ruarchi/BeamSplitter/stl/alternatives/frame_for_0.6_nozzle.stl

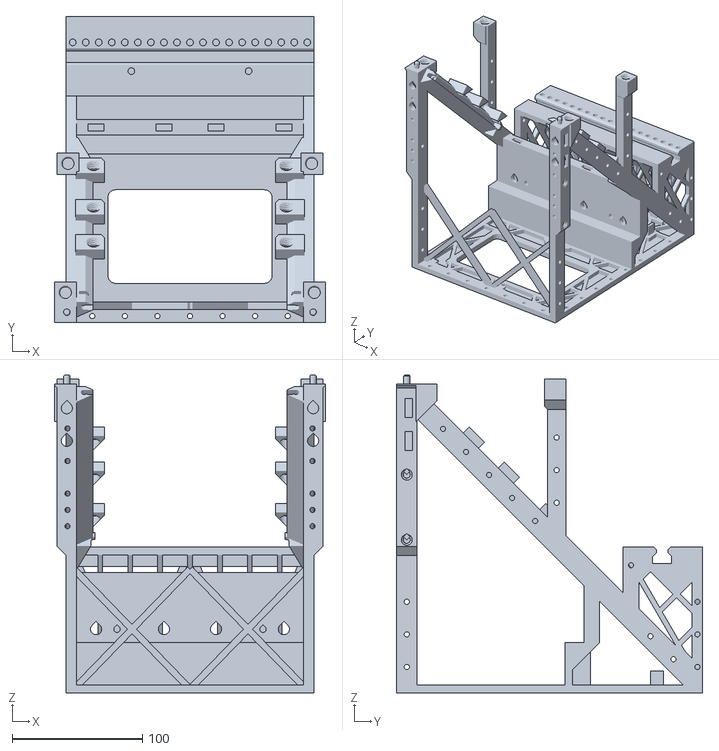
[picture p6: CAD file, 2026-10-24]
stl/alternatives/frame_for_0.6_nozzle.stl
208.0 x 235.0 x 244.0
