ruarchi/BeamSplitter/stl/tests/rail_test.stl

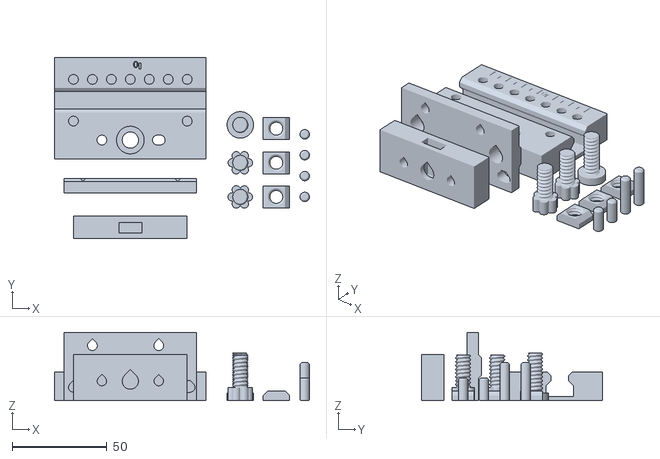
[picture p7: CAD file, 2026-10-24]
stl/tests/rail_test.stl
134.5 x 95.6 x 36.0
