ruarchi/BeamSplitter/stl/tests/thread_test.stl

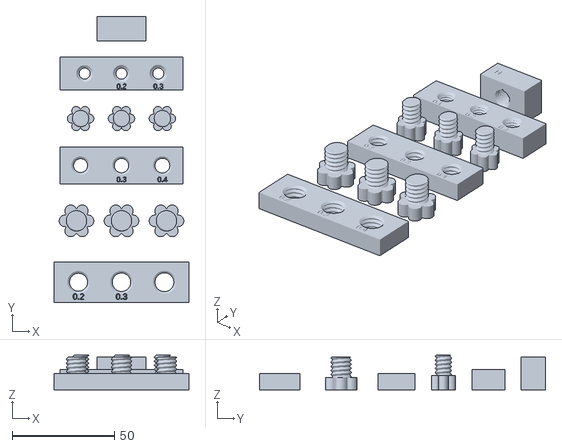
[picture p8: CAD file, 2026-10-24]
stl/tests/thread_test.stl
66.0 x 140.0 x 17.0
