ruarchi/BeamSplitter/stl/05_bottom_carriage.stl

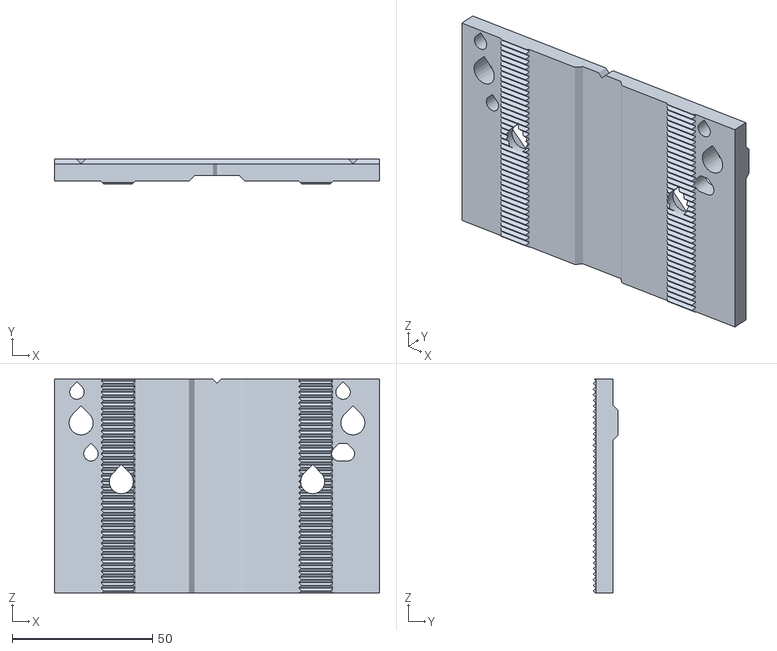
[picture p9: CAD file, 2026-10-24]
stl/05_bottom_carriage.stl
116.0 x 8.80 x 76.2
