ruarchi/BeamSplitter/stl/alternatives/arca_plate.stl

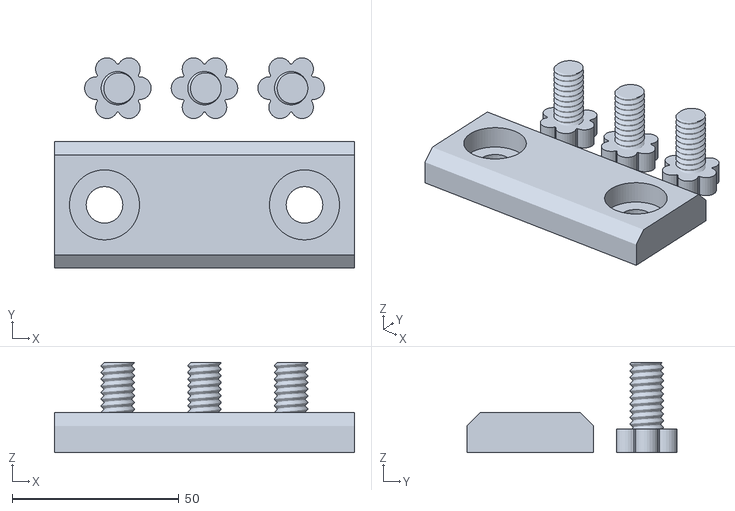
[picture p10: CAD file, 2026-10-24]
stl/alternatives/arca_plate.stl
90.0 x 63.1 x 27.0
