ruarchi/BeamSplitter/stl/tests/groove_test.stl

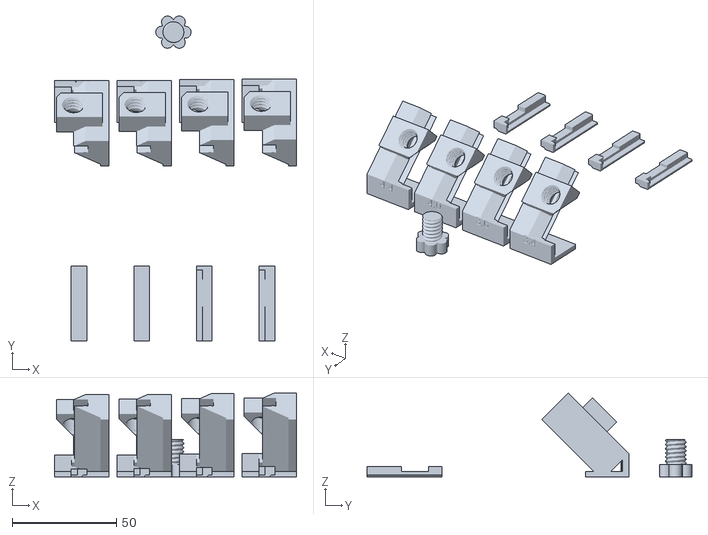
[picture p11: CAD file, 2026-10-24]
stl/tests/groove_test.stl
116.2 x 155.7 x 40.2
