ruarchi/BeamSplitter/stl/14_pins_solid.stl

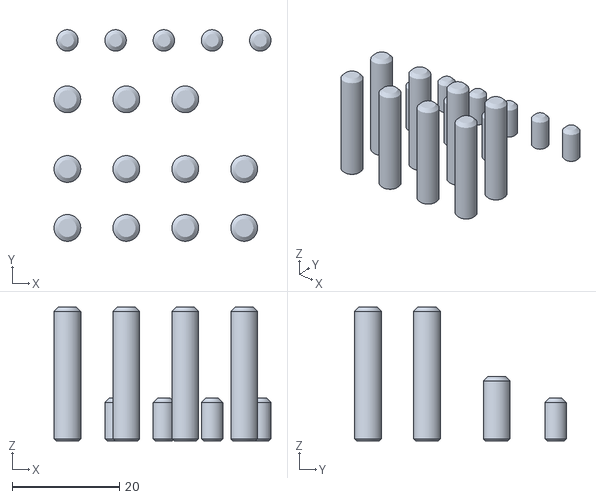
[picture p12: CAD file, 2026-10-24]
stl/14_pins_solid.stl
40.5 x 39.5 x 25.0
