ruarchi/BeamSplitter/stl/tests/pin_test.stl

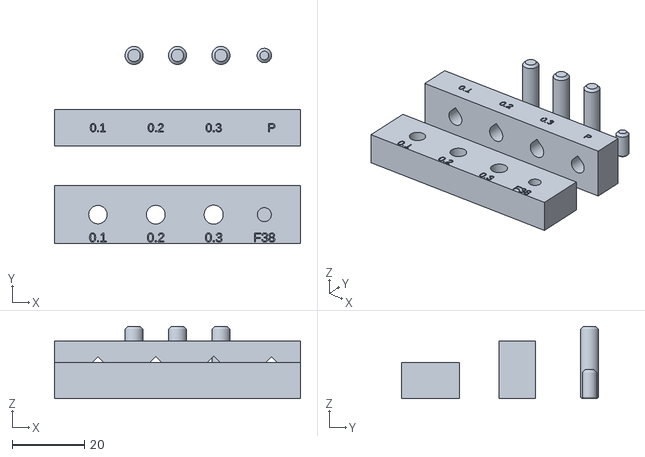
[picture p13: CAD file, 2026-10-24]
stl/tests/pin_test.stl
68.0 x 54.5 x 20.0
