ruarchi/BeamSplitter/stl/08_groove_strips_x2.stl

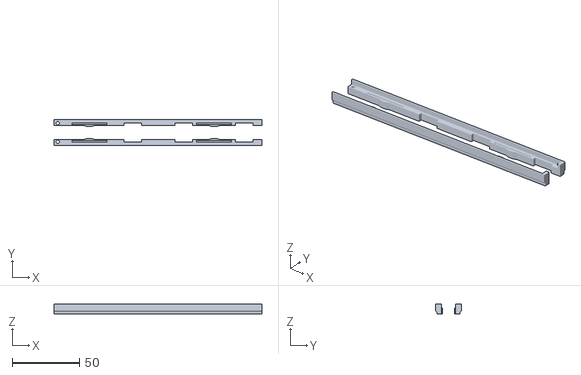
[picture p14: CAD file, 2026-10-24]
stl/08_groove_strips_x2.stl
154.3 x 19.4 x 7.60
