ruarchi/BeamSplitter/stl/15_wrap_clips.stl

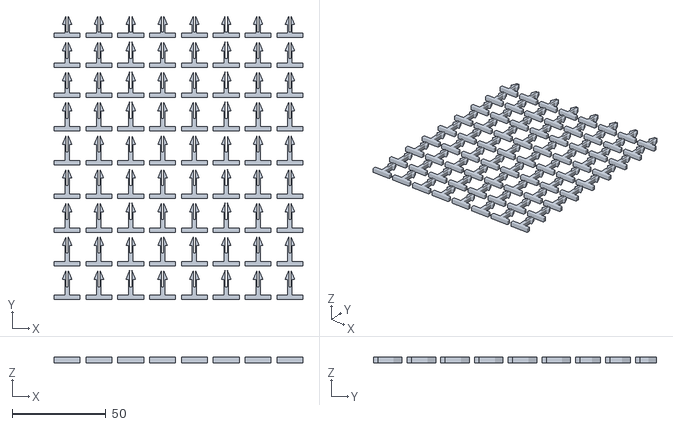
[picture p15: CAD file, 2026-10-24]
stl/15_wrap_clips.stl
133.0 x 151.4 x 3.00
