ruarchi/BeamSplitter/stl/10_swap_shim_3mm_riser.stl

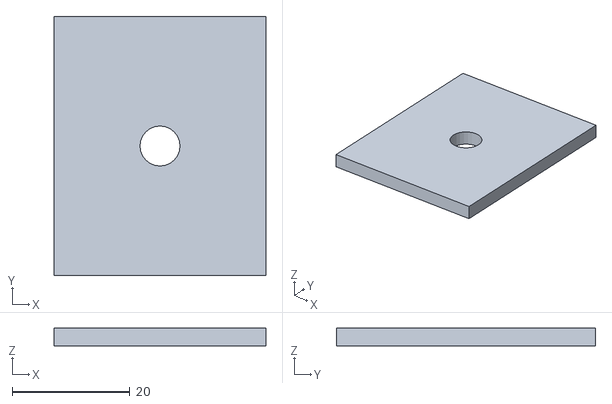
[picture p16: CAD file, 2026-10-24]
stl/10_swap_shim_3mm_riser.stl
36.0 x 44.0 x 3.00
