ruarchi/BeamSplitter/stl/03_wall_rail.stl

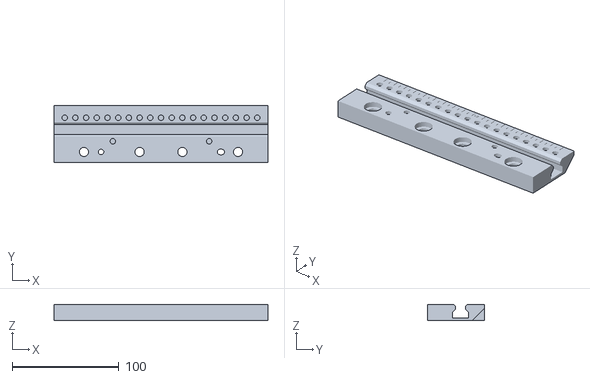
[picture p17: CAD file, 2026-10-24]
stl/03_wall_rail.stl
200.0 x 53.6 x 15.0
