ruarchi/BeamSplitter/stl/09_shim_set_print_2x.stl

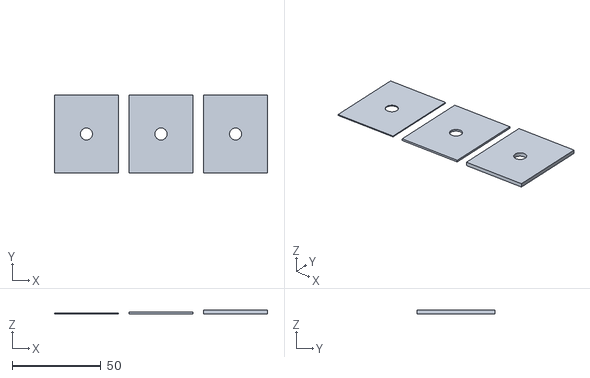
[picture p18: CAD file, 2026-10-24]
stl/09_shim_set_print_2x.stl
120.0 x 44.0 x 2.00
