ruarchi/BeamSplitter/stl/04_rear_carriage.stl

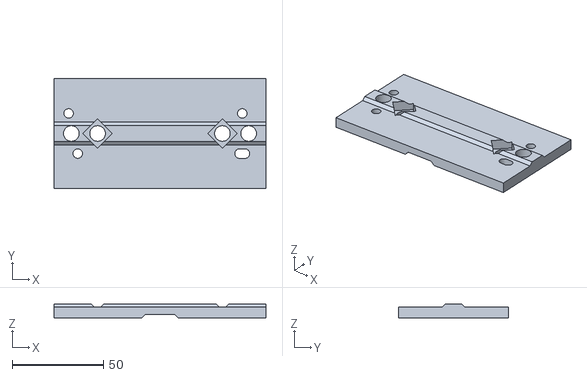
[picture p19: CAD file, 2026-10-24]
stl/04_rear_carriage.stl
116.0 x 60.0 x 7.80
