ruarchi/BeamSplitter/stl/02_top_lid.stl

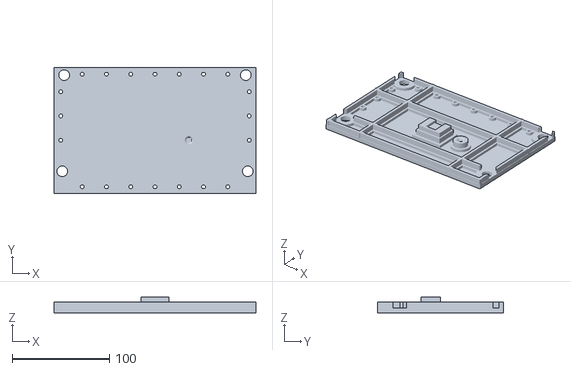
[picture p20: CAD file, 2026-10-24]
stl/02_top_lid.stl
208.0 x 130.0 x 16.2
