ruarchi/BeamSplitter/stl/07_glass_stops_x2.stl

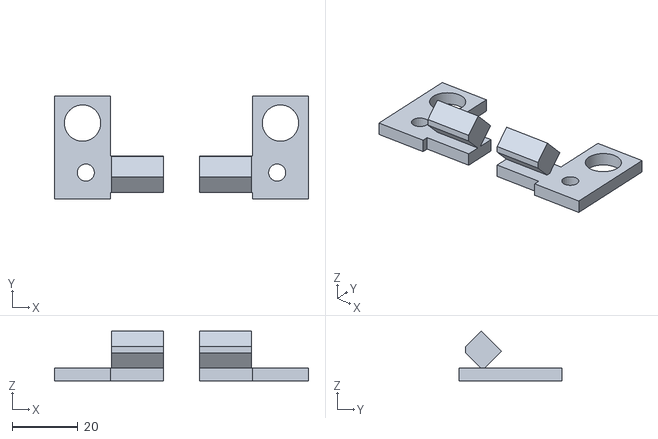
[picture p21: CAD file, 2026-10-24]
stl/07_glass_stops_x2.stl
77.0 x 31.2 x 15.1
