ruarchi/BeamSplitter/stl/06_f38_slides_x2.stl

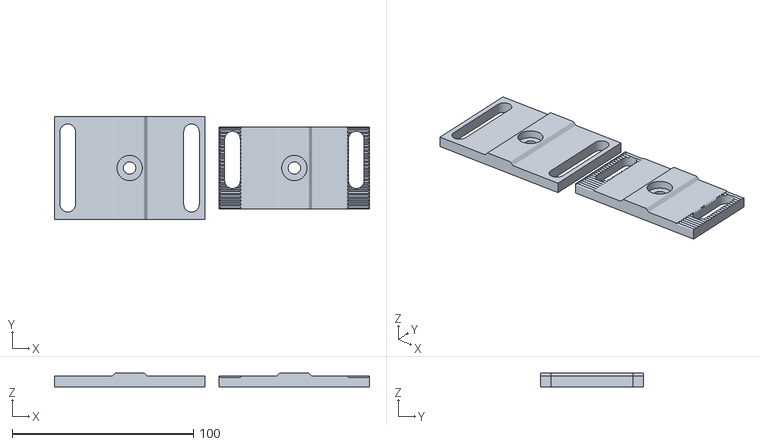
[picture p22: CAD file, 2026-10-24]
stl/06_f38_slides_x2.stl
173.8 x 56.6 x 7.80
