ruarchi/BeamSplitter/stl/12_hardware_nuts_solid.stl

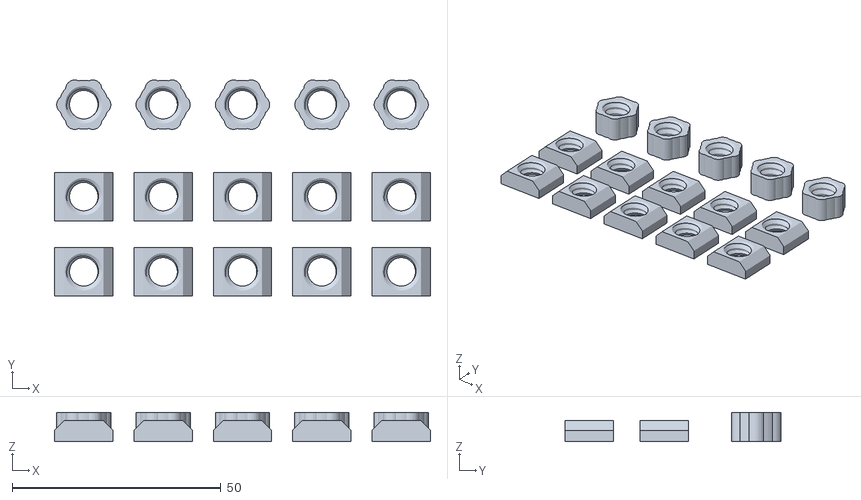
[picture p23: CAD file, 2026-10-24]
stl/12_hardware_nuts_solid.stl
90.0 x 51.7 x 7.00
