ruarchi/BeamSplitter/model/beamsplitter_rig.scad

// BeamSplitter -- dual-camera beam-splitter rig (parametric, 3D-printable).
// A 150 x 150 x 2 mm 50/50 plate beam splitter at 45 deg between two cameras: the rear camera looks
// through the glass, the bottom camera looks up at the reflection. Both slide sideways for stereo.
// Parameters, measuring your gear: docs/CUSTOMIZE.md. Printing, assembly, design: see docs/.
//
// Usage: part = "assembly" draws the whole rig (F5). Any other part name draws one printable part
// in print orientation: F6, then File > Export > STL. Command line:
//   openscad -D 'part="frame"' -o frame.stl beamsplitter_rig.scad
// The console prints a summary of optical margins and clearances; an assert stops the run when a
// parameter combination does not fit. Everything below "DERIVED VALUES" is computed.
//
// Units: mm and degrees.
// World frame: X left/right, Y front/back (the scene is at -Y), Z up. X = 0 is the centreline,
//   Y = 0 the splitter centre, Z = 0 the underside of the base. Splitter centre S = (0, 0, Zs).
//   The coated face has normal (0,-1,-1)/sqrt2 (toward the scene and the bottom camera).
//   The rear camera looks -Y, the bottom camera looks +Z.
// Plate-local frame (grooves, ribs): x = world X; v = along the plate, +v = rear/lower edge
//   (world (0,1,-1)/sqrt2); w = plate normal toward the uncoated back (world (0,1,1)/sqrt2).
//   The coated face is w = 0 (through S); the glass occupies w = 0 .. plate_t, v = -75 .. +75.
//   Mapping: translate([0,0,Zs]) rotate([-45,0,0]) (see place_plate()).

/* [What to draw] */
// Part to draw: "assembly" = the whole rig; any other name = one printable part, laid flat for printing
part       = "assembly"; // [assembly, frame, top_lid, wall_rail, glass_stop, preload_screw, rear_carriage, bottom_carriage, f38_slide, hood, shim_set, swap_shim, groove_test, groove_strip, thread_test, rail_test, pin_test, hardware_screws, hardware_nuts, pin_set, wrap_clips, hood_hardware, arca_plate, splitter_mockup, camera_mockups, insert_check, strip_insert_check, world, none]
// With part = "world": one printed part in its assembled position (for mass, centre of gravity and clash checks)
world_piece = "frame";   // [frame, top_lid, wall_rail, groove_strip, glass_stop, preload_screw, rear_carriage, bottom_carriage, f38_slide, swap_shim, hood, hardware, arca_plate]
// Assembly: draw the camera fields of view (orange = rear, purple = bottom; not parts)
show_fov   = true;
// Assembly: draw the top lid (translucent in preview only)
show_lid   = true;
// Assembly: draw the optional front hood
show_hood  = false;
// Assembly: draw the camera, lens and F38 mock-ups
show_cams  = true;
// Assembly: remove the +X half of frame, lid and hood to look inside
cutaway     = false;
// Assembly: slide the glass this far up-front along its grooves (0 = seated; > 0 hides the lid and stops)
glass_insert = 0;
// Smaller printer: cut the rear deck off the frame at Y = split_y (bolted lap joint, steel M4 screws)
frame_split = false;
// With frame_split: which piece to draw ("both" = side by side)
split_piece = "both";    // [front, rear, both]

/* [Hardware and tripod mount] */
// "printed" = printed thumbscrews, nuts, pins and clips; "steel" = M4 bolts, square nuts, steel dowel pins, heat-set inserts
hardware   = "printed";  // [printed, steel]
// Tripod socket: "insert" = 1/4"-20 heat-set insert (recommended: the loaded rig hangs on it), "printed" = printed 1/4"-20 thread, "arca" = printed Arca-Swiss plate on 2 printed M10 thumbscrews
tripod_mount = "insert"; // [insert, printed, arca]

/* [Stereo] */
// Rear camera sideways offset toward +X, mm (stereo; at most rear_stereo)
stereo_rear = 0;         // [-40:5:40]
// Bottom camera sideways offset toward -X, mm (stereo; give a positive number; at most bot_stereo)
stereo_bot  = 0;         // [-45:5:45]
// Print the stereo clipping readout when a stereo offset is set (ray sampling, ~30 s; false = faster preview)
clip_check  = true;
// Rays across x down the target frame, per camera
clip_grid   = [64, 36];

/* [Measure first: cameras, lenses, F38, filter, glass] */
// Measure these on your own hardware before printing the frame (docs/CUSTOMIZE.md explains how).
// Entrance pupil depth behind the front element, rear lens (parallax method)
ep_15       = 25;
// Entrance pupil depth, bottom lens at its working focal length, from the BARE lens front (filter not counted)
ep_1018     = 25;
// Screw-in IR filter on the bottom lens: ring outer diameter
filt_od     = 65;
// How far the filter sticks out beyond the bare lens front (toward the glass)
filt_len    = 6;
// Camera axis heights: enter the UPPER end of your ruler reading.  An error then leaves the camera slightly LOW
// (rear) or slightly too close to the crosswall (bottom), which the shim_set (0.5 / 1 / 2 mm) takes up:
// shims can only space a camera away from its mount, never pull it closer.
// Rear camera (a6400): [axis height above the tripod face, flange -> tripod socket, flange -> rear LCD]
a6400_meas  = [35, 18, 45];
// Bottom camera (a5100): [axis height above the tripod face, flange -> tripod socket, flange -> rear LCD]
a5100_meas  = [32, 15, 33];
// Rear camera body envelope [width (X), height, depth incl. grip]
a6400_size  = [120.0, 66.9, 59.7];
// Bottom camera body envelope [width (X), height, depth incl. grip]
a5100_size  = [109.6, 62.8, 35.7];
// Rear lens (Sony E 15 mm F1.4 G): [diameter, length mount -> front]
lens_15   = [66.6, 69.5];
// Bottom lens (Sony E 10-18 mm F4 at 18 mm): [diameter, length mount -> front]
lens_1018 = [70.0, 63.5];
// F38 quick release: slide top -> camera tripod face, plate clicked into the base (enter the upper end of the reading)
f38_stack   = 17;
// F38 base footprint [along camera X, along the slide travel]
f38_base    = [54.3, 41.3];
// Locating pins pressed into the slide, into the holes in the F38 base (false = no pins)
f38_pins    = true;
// Locating hole / pin diameter (slide hole = f38_pin_d - 0.1, press fit)
f38_pin_d   = 4.0;
// Pin spacing along camera X, centred on the 1/4" screw
f38_pin_sp  = 30;
// Pin hole depth in the slide (pins stand about 3 mm proud; at most t_slide - 1)
f38_pin_depth = 5;
// Usable depth of the F38 base's 1/4"-20 thread (through hole: depth to the quick-release cavity floor)
f38_thread_depth = 8;
// Length of the 1/4"-20 screw that holds the F38 base (3/8" = 9.5); its engagement is checked
qtr_screw_len = 9.5;
// Release lever / safety knob: [how far it sticks out beyond the base along camera X (0 = inside), its lowest point above the base underside]
f38_lever   = [0, 99];
// Camera-side footprint of the F38 plate (the shims go between camera and F38 plate)
shim_fp     = [36, 44];
// Your glass, measured: [width across X, length along the slope]; the groove strips are made for it
strip_glass = [150, 150];

/* [Optics] */
// Splitter centre height above the base underside
Zs          = 176;
// Target common-frame focal length (19 = the smallest 0.5 mm step that passes with the default IR filter); set fov_f_rear / fov_f_bot the same
target_f    = 19;
// Target frame aspect: "16:9" or "3:2"
target_aspect = "16:9";
// Design distance plate centre -> lens front element
g           = 41.5;
// Required clearance of a lens rim from the other camera's field of view
rim_margin  = 3;
// Lens-to-glass clearance, measured normal to the plate
plate_clear_min = 3;
// Focal length of the drawn rear field of view
fov_f_rear  = 19;
// Focal length of the drawn bottom field of view
fov_f_bot   = 19;
// Aspect of the drawn fields of view: "16:9" or "3:2"
fov_aspect  = "16:9";
// How far the rear field of view is drawn from its pupil
fov_len     = 190;
// Frame / hood clearance outside the target field of view
aperture_margin = 3;
// Minimum clearance of groove lips, stops, bosses and screw heads outside both fields of view
lip_margin_min = 0.5;
// Sensor width (APS-C)
sensor_w    = 23.5;
// Sensor height, 3:2
sensor_h32  = 15.6;
// Frame height, 16:9
sensor_h169 = 13.22;
// Lens clearance envelope: diameter + this
lens_clear_d = 6;
// Lens clearance envelope: length + this
lens_clear_l = 10;
// Beam-splitter plate size (square)
plate_size  = 150;
// Beam-splitter plate thickness
plate_t     = 2.0;
// Glass edge engagement in the groove (clear aperture = plate_size - 2 * glass_engage)
glass_engage = 2;

/* [Glass groove and preload] */
// Groove stack (plate normal, from the coated face down): 0.5 mm hard felt on the LOWER flank (the angle reference;
// the glass rests on it by gravity), the 2 mm glass, then one 0.5 mm felt layer on the UPPER flank (add a second only
// if the glass rattles), pressed by the printed preload thumbscrews.  Cut the upper felt
// strip no wider than the groove roof (x_ul .. x_gb, printed in the summary): a wider strip hangs into the view.
// Groove width: deliberately generous so the glass always fits; the slack is taken up by the felt and the thumbscrews
groove_w    = 4.0;
// Lower-flank felt thickness (the lower flank face sits felt_t below the coated face)
felt_t      = 0.5;
// Gap glass edge -> groove bottom
edge_float  = 1.0;
// Lip rule: the lower flank face stands at most 1.5 mm proud of the coated face ...
lip_proud   = 1.5;
// ... for this width, then it bevels away
lip_flat    = 1.5;
// Bevel run in X per mm of depth (>= 1.46 = the grazing-ray slope; both flanks)
bevel_k     = 1.6;
// Upper flank starts this far outboard of the lower lip edge (+ 0.5 per mm of groove_w above 3.2, see x_ul_of())
ul_off      = 1.0;
// Upper flank thickness above the groove roof
back_flank  = 3.5;
// Felt pad on the closed lower-rear end stop
end_pad     = 1.0;
// Clearance glass (+ felt) -> top glass_stop
stop_gap    = 0.5;
// Closed end-stop thickness
end_t       = 5;
// Top-front glass stop, one per side (printed: hooked on the lid pin, clamped by the lid; steel: M4 bolt along the groove)
// Stop block thickness along the groove
stop_len    = 8;
// Stop inner edge |X| (beyond the glass end, outside the views: asserted)
stop_x0     = 71;
// w range of the stop block (covers the glass edge + felt)
stop_w      = [-6, 2.7];
// Steel: M4 x 16 socket head stop bolt
stop_bolt_len = 16;
// Minimum distance of anything to the frame front face y_front
front_margin = 2;
// Preload screws through the UPPER flank, perpendicular to the glass
// "printed" = printed M10 thumbscrews with felt on the tip; "m4" = M4 nylon screw + square nut
preload_type = "printed";// [printed, m4]
// Screw positions along the groove (the rear one sits where the rear lens clears its head at full stereo travel)
preload_v   = [-18, 20, 65];
// Screw axis |X| (the tip straddles the glass edge)
x_pl        = 74;
// Printed thread major diameter
ps_d        = 10;
// Printed thread pitch (45° flanks, support-free; 1.5 .. 2.5 allowed)
ps_pitch    = 2.0;
// Radial clearance of the printed internal threads: print thread_test and pick the best fit (0.2 / 0.3 / 0.4)
ps_clear    = 0.2;
// Boss wall around the thread
ps_wall     = 3;
// preload_screw threaded length (boss 10 + 2 mm adjustment)
ps_len      = 12;
// Thumb head [diameter over the lobes, height]
ps_head     = [17, 6];
// Preload boss height above the groove roof (= thread length)
boss_h      = 10;

/* [Swappable groove strips] */
// The glass sits in two printed groove strips (one per side) that slide into a channel in the frame's diagonal ribs.
// The ANGLE is still set by the frame: each strip's flat underside rests on the rib's seat face (the plane
// w = -lip_proud), so a strip of uniform thickness cannot change the angle.  The strip carries the lower lip (felt
// face = the reference face), a spine that fills the channel up to its roof, and the lower-rear end stop: a glass that
// is a little too wide / narrow / long / short only needs new strips (strip_glass, in "Measure first"), never a new
// frame.  Two leaf springs in the spine press the strip onto the seat, so it stays in by itself; under each thumbscrew
// the spine drops below the glass top, so the screws press only the glass.  The strips stay inside the rib envelope
// (same optical margins).  They print on their outer face (springs = vertical walls, no bridges).
// true = swappable strips; false = groove integral in the frame (always with hardware = "steel")
groove_strips = hardware == "printed";
// Frame channel length clearance at the lower-rear end (frame geometry)
strip_clr   = 0.2;
// Channel outer wall |X| (frame geometry; the rib keeps x_ch .. x_rw of wall for the roof and the bosses)
x_ch        = 81;
// Strip spine height above the coated face under each thumbscrew (the screw tips must reach the glass top first)
strip_floor = 1.0;
// Strip top -> channel roof clearance (the springs take up the rest)
strip_top_clr = 0.5;
// Strip outer face -> channel wall clearance
strip_side_clr = 0.4;
// Lower-rear end cap thickness (glass end stop) at the nominal glass length (frame geometry: sets the channel length)
strip_cap   = 2.0;
// Lateral key: a ridge on the rib seat (|X| range, under the strip's spine; frame geometry) ...
key_x       = [78.8, 80.2];
// ... ridge height above the seat (frame geometry); the strip underside is relieved over it (a step, open outboard)
key_h       = 0.6;
// ... play between the strip's step and the ridge's inner face (the ridge stops the strip moving outboard)
key_clr     = 0.3;
// Hold-down springs: a thin leaf in the spine top with a bump that stands proud of the roof.  Centres along the groove
// (between the thumbscrews) ...
spring_v    = [-50, 42.5];
// ... free length of each leaf
spring_len  = 26;
// ... leaf thickness
spring_t    = 0.8;
// ... free room under the leaf
spring_gap  = 1.0;
// ... how far the bump stands above the roof (= how far the leaf bends when the strip is in)
spring_bump = 0.35;
// Pull hole through the spine near the open end (hook a bent paper clip in it to pull the strip out)
strip_pull_d = 2.5;

/* [Frame] */
// Side-truss member thickness (X): side plane x = inner_hw .. wall_out
wall_t      = 8;
// Inner face of the side plane |X| (glass + groove + rib)
inner_hw    = 87;
// Base plate thickness (bottom chord; the X-braces take the racking)
base_t      = 6;
// Frame front face Y (glass stop + margin: asserted)
y_front     = -65;
// Frame rear face Y
y_back      = 170;
// Lid rear edge Y (splitter zone)
y_zone_end  = 65;
// Rear deck plate thickness (the rail band under it is rail_band_d deep)
deck_t      = 6;
// Rear carriage plate thickness
t_rear_carriage = 6;
// f38_slide thickness, both slides
t_slide     = 6;
// Front column outboard width (X) at the front face
col_w       = 15;
// Front post depth (Y)
col_d       = 16;
// Clearance highest glass / stop / rib point -> lid underside
lid_clear   = 3;
// Lid rib thickness
rib_t       = 3;
// Rear-deck rib thickness
deck_rib_t  = 3.5;
// Structural deck ribs at x = 0, +-rib_pitch_x (the rear W-truss nodes) ...
rib_pitch_x = 46;
// ... plus intermediate deck ribs at these |x| (keeps the deck / rail-band bridges <= 20 mm)
deck_rib2_x = [23, 69];
// Rear post Y span (carries the rear lid screws)
rp_y        = [51, 65];
// Rear post inner face |X|
rp_x0       = 85;
// Deck strut (rib -> deck front edge) depth in Y
strut_d     = 12;
// Deck side-rib web thickness (outer part of the side plane)
side_rib_t  = 5;
// Diagonal rib cross-section (w) below the groove zone (its underside continues the groove-zone band: no mid-air start)
diag_w_lo   = [-7, 7];
// Tapered gusset at the rib's lower-rear end (where the thick groove rib meets the side-plane band and the rear post):
// longest length (shortened automatically to stay 3 mm above the crosswall top)
gusset_max  = 21;
// Lightening: floor of the blind base pockets (4 layers at 0.4)
skin_t      = 1.6;
// Lattice web thickness (base)
web_t       = 3.5;
// Through-truss members (deck ribs)
truss_web   = 4;
// Diamond lattice pitch, deck ribs (through)
truss_pitch = 40;
// Triangle lattice edge, base pockets (open-top, blind)
base_tri    = 56;
// Recess in the base under the bottom camera's LCD
lcd_recess  = true;
// Window: the recess goes right through the base, so you can see the bottom camera's screen and reach its buttons
lcd_window  = true;
// Window corner radius
lcd_window_r = 6;
// LCD recess floor thickness
lcd_floor_t = 2.0;
// Minimum clearance bottom camera LCD -> base / recess floor at the lowest slide position
lcd_clear_min = 3;
// Side accessory points (1/4"-20 sockets in the front column outer faces): heights
acc_z       = [117.5, 167.5];
// Hood mounting screw heights
hood_bolt_z = [Zs + 17.5, Zs + 42.5];
// Rear rail band depth below the deck top (T-slot 12.7 printed / 9.8 steel)
rail_band_d = hardware == "printed" ? 15 : 13;
// CROSSWALL: vertical wall between the side trusses behind the bottom camera.  The bottom carriage rides on the front
// face y_wf of the WALL_RAIL (a separate bar with the T-slot, printed lying flat), which is bolted to the flat
// mounting face of the wall at y_wf + wrl_t.
// Wall band thickness (Y) behind the wall_rail (bolts, nut slots, pin holes)
cw_band_t   = hardware == "printed" ? 12 : 9;
// Base kept solid under the wall foot: y_wf - web_t .. y_wf + cw_foot_t + web_t
cw_foot_t   = 12;
// Wall thickness below the rail (its front face sits wrl_relief behind the rail face) ...
cw_web_t    = 6;
// ... with blind triangular pockets from the back, leaving this front skin
cw_skin     = 1.6;
// Pocket webs (45° members) in the wall
cw_web      = 4;
// Pocket lattice pitch (45° diamonds; the bottom row is cut into triangles)
cw_pitch    = 24;
// Two vertical stiffening ribs on the wall's back face at x = +-cw_rib_x ...
cw_rib_x    = 30;
// ... [width X, depth Y beyond the web], from the base to the 45° knee under the band
cw_rib      = hardware == "printed" ? [6, 14] : [6, 10];
// Wall rail (T-slot) centre height (the clamp screws sit in the front X-brace window: asserted)
wr_z        = 70;
// Pin rows at wr_z +- wr_off (index row up, datum pair down)
wr_off      = hardware == "printed" ? 11 : 9;
// Scale strip on the rail face above the carriage top (engraved ticks)
wr_scale_h  = 5;
// Index holes over this length (x = -90 .. 90, 10 mm pitch)
wr_idx_len  = 180;
// WALL_RAIL: printed lying flat (back face on the bed), so its T-slot opens upward: no overhangs, no mid-air starts.
// Rail thickness (Y): T-slot (12.7 printed / 9.8 steel deep) + floor
wrl_t       = hardware == "printed" ? 15 : 12;
// Rail bottom edge relative to wr_z (through-bolt row + its counterbore + wall)
wrl_lo      = hardware == "printed" ? -31 : -18;
// The wall web face sits this far behind the rail face: the carriage bears on the rail only
wrl_relief  = 0.5;
// Rail bottom edge above the wall's rail seat (the pins locate the rail, not the seat)
wrl_gap     = 0.3;
// Through-bolt + alignment-pin row relative to wr_z (below the datum row)
wrl_bolt_h  = hardware == "printed" ? -21 : -11;
// Through-bolts: head in a counterbore in the rail face (under the carriage), nut dropped into a slot from the band top
wrl_bolt_x  = [-72, -20, 20, 72];
// Through-bolt length (printed M8 x 21 + printed T-nut / steel M4 x 16 + square nut)
wrl_bolt_len = hardware == "printed" ? 21 : 16;
// Wall material between the mounting face and the nut slot
wrl_nut_f   = 3;
// 2 alignment pins: round rail hole at [0], slotted (along X) at [1]; wall holes round (teardrop)
wrl_dowel_x = hardware == "printed" ? [-56, 56] : [-50, 50];
// Alignment pin length (printed 5 mm pins pressed in; steel: 4 mm dowels, reamed, glued)
wrl_dowel_len = 12;
// Alignment pin hole depth in the wall
wrl_dowel_wall = 6.5;
// X-braces between the two side trusses (racking in the X-Z plane): member width (in the brace plane)
brace_w     = 5;
// X-brace member thickness (Y)
brace_t     = 6;
// Steel: 2 x 4 mm lid dowels in the front post tops (the lid does not rely on screw friction): length
lid_dowel_len   = 12;
// Steel: lid dowel glued into the post top this deep (3 mm proud)
lid_dowel_depth = 9;
// Steel: blind dowel hole depth in the lid underside
lid_dowel_lid   = 3.5;

/* [Printed hardware] */
// Printed threads: two standards with the same 2 mm pitch and 45° flanks: M10 x 2 (ps_d / ps_pitch / ps_clear) where
// space allows (lid, Arca plate), M8 x 2 where a 13 mm head must fit (carriage and slide clamps, wall_rail bolts, hood).
// Screws and bolts print standing (head on the bed), nuts print flat (thread axis vertical), 100 % infill.
// Second printed standard: M8 x 2 (pitch ps_pitch, clearance ps_clear, same 45° form)
t8_d        = 8;
// Lid thumbscrew M10: thread length under the head
lid_sl      = 20;
// Lid thumbscrew lobed head [diameter over the lobes, height]
lid_sh      = [20, 7];
// Carriage rail clamp thumbscrew M8: thread length under the head (tip past the T-nut: asserted)
cs_len      = 17;
// Clamp thumbscrew lobed head [diameter, height], with a hex socket (long key through the front brace window)
cs_head     = [13, 7];
// Hex socket across flats in the clamp thumbscrews and wall_rail bolts
hex_key     = 5;
// T-nut M8 [across the slot, along the slot, thickness]; its 45° top bevels bear on the slot roof
tnut        = [14, 11.6, 5];
// Slide clamp T-bolt M8: square head [side, thickness], sits in a diamond pocket under the carriage
sb_head     = [11, 3.5];
// Slide clamp T-bolt thread length above the head (carriage + slide + thumb-nut)
sb_len      = 16;
// Slide thumb-nut M8 [diameter over the lobes, height]; its bed face is the bearing face
sn_size     = [13, 7];
// wall_rail bolt M8 head [diameter, height] (counterbored under the carriage, hex socket)
wb_head     = [14, 4];
// Printed pins: datum / vernier / wall_rail alignment pin diameter (F38 pins: f38_pin_d)
pin_d       = 5;
// Slip-fit pin hole = pin_d + pin_clr (print pin_test and pick: 0.1 / 0.2 / 0.3)
pin_clr     = 0.2;
// Press-fit pin hole = pin_d + pin_press (alignment pins in the crosswall band)
pin_press   = 0.0;
// glass_stop ear thickness = how far the front post tops sit below frame_top (the ear lies there under the lid)
ear_t       = 4;
// Integral lid pins stand this far above frame_top
lid_pin_up  = 3.0;
// Printed 1/4"-20 UNC female threads for steel screws (printed tripod socket, lid and side accessory points):
// radial clearance at the major diameter (thread_test: 0.1 / 0.2 / 0.3)
unc_clr     = 0.2;
// Printed minor (hole) diameter (UNC 2B: 4.98 .. 5.26; printed holes come out ~0.1 small)
unc_minor   = 5.35;
// tripod_mount = "printed": thread depth (tripod screws engage at most this deep)
tri_thr_depth = 12;
// wrap_clip grip lengths: side members / base + lid / deck ribs
wrap_grip   = [8.5, 6.5, 4.5];
// Number of clips of each length on the wrap_clips plate (incl. spares)
wrap_qty    = [48, 16, 8];

/* [Holes, inserts and steel hardware] */
// 1/4"-20 clearance hole
qtr_clear   = 6.8;
// 1/4"-20 screw head diameter (counterbored into the slide underside)
qtr_head_d  = 13;
// 1/4"-20 screw head height
qtr_head_h  = 4;
// M4 clearance hole
m4_clear    = 4.6;
// Counterbore for an M4 socket head: diameter
m4_head_d   = 8.5;
// Counterbore for an M4 socket head: depth
m4_head_h   = 4.2;
// M4 square nut: width
sqnut_w     = 7.0;
// M4 square nut: thickness
sqnut_t     = 2.5;
// Added to nut width / thickness for nut traps
nut_clear   = 0.3;
// Pin holes (printed pins: slip fit; steel: 3.8, reamed to 4.0)
dowel_hole  = hardware == "printed" ? pin_d + pin_clr : 3.8;
// Steel: lid dowel holes in the post tops (reamed to 4.0, pin glued in with a drop of CA)
lid_dowel_hole = 3.8;
// Carriage datum / vernier pin length (printed 5 x 25 / steel 4 x 25; at least 3 mm proud of the carriage: asserted)
dowel_len   = 25;
// Blind pin / index hole depth in the rails
dowel_depth = 9;
// Heat-set insert 1/4"-20: hole diameter
ins14_d     = 8.0;
// Side accessory points: 1/4"-20 x 10 insert depth
ins14_depth = 10;
// Heat-set insert 3/8"-16: hole diameter
ins38_d     = 11.5;
// Heat-set insert 3/8"-16: hole depth
ins38_depth = 12;
// Lid 1/4"-20 socket depth (leaves 3 mm over the flocked underside)
lid_ins_depth = 8;
// Zip-tie / wrap hole diameter
zip_d       = 4;
// Zip-tie / wrap hole pitch
zip_pitch   = 25;

/* [Tripod] */
// One socket in the base underside, in the crosswall foot just behind the wall front face: stiff plate contact on
// both sides of the screw.
// Socket X
tri_x       = 0;
// The socket pad starts this far behind the crosswall front face
tri_gap     = 2.4;
// 1/4"-20 x 8 mm insert depth (tripod screws engage <= 6.5)
tri_ins_depth = 8;
// Material above the insert (>= 2)
tri_roof    = 2;
// Pad diameter (round boss merged into the base)
tri_pad_d   = 16;
// Base left solid around the socket = tripod plate contact area
tri_solid_d = 46;
// true: 3/8"-16 insert instead of 1/4"-20
tri_38      = false;

/* [Rails, carriages and slides] */
// Rear rail band width (Y)
rail_w      = 36;
// Index hole pitch
rail_pitch  = 10;
// Guide groove width at the rail top (the carriage tongue rides in it); tongues and grooves have 45° sides
key_w       = hardware == "printed" ? 13 : 10;
// Guide groove depth
key_d       = 2;
// T-slot neck width (retains the T-nut)
neck_w      = hardware == "printed" ? 9 : 5;
// T-slot neck depth
neck_d      = 2.5;
// Extra nut-chamber depth below the nut (bolt tip room)
bolt_runout = 1.0;
// Tongue clearance per side
tongue_clear = 0.2;
// Carriage -> rail clamp head seat above the carriage's rail face (printed: the thumbscrew head sits on the carriage)
clamp_seat  = hardware == "printed" ? 6 : 3;
// Rear (deck T-slot) clamp screw length
clamp_bolt_len = hardware == "printed" ? cs_len : 12;
// Bottom (wall_rail T-slot, same profile) clamp screw length
wclamp_bolt_len = hardware == "printed" ? cs_len : 12;
// Rear carriage (clamp screws + pins outside the F38 slide, reachable from above): length X
rc_len      = hardware == "printed" ? 116 : 110;
// Rear carriage width Y
rc_width = 60;
// Rear carriage clamp axis |x|
rc_clamp_x  = hardware == "printed" ? 48.5 : 46;
// Rear carriage datum pin spacing
rc_datum_sep = hardware == "printed" ? 90 : 86;
// Rear carriage vernier pin holes x
rc_vern = [-50, 45];
// Rear rail pin rows at +-rc_idx_off
rc_idx_off = 11;
// Rear rail index holes over this length
rc_idx_len = 180;
// Bottom carriage (flat plate on the wall_rail; clamp screws + pins outside the slide): length X
bc_len      = hardware == "printed" ? 116 : 110;
// Bottom carriage clamp axis |x|
bc_clamp_x  = hardware == "printed" ? 48.5 : 46;
// Bottom carriage datum pin spacing
bc_datum_sep = hardware == "printed" ? 90 : 86;
// Bottom carriage vernier pin holes x
bc_vern = [-50, 45];
// Rear slide travel (fore-aft, Y) for viewpoint matching
rear_travel = 40;
// Bottom slide travel (up-down, Z) for viewpoint matching
bot_travel  = 20;
// Rated rear stereo travel +- (5 mm index steps via the vernier holes; lens clearance asserted)
rear_stereo = 40;
// Rated bottom stereo travel +-
bot_stereo  = 45;
// Slide <-> carriage guide: 45° trapezoid tongue under the slide (root width) in a carriage groove ...
guide_w     = 20;
// ... its depth; wide enough to hide the 1/4" screw head inside it
guide_d     = 2;
// Steel: carriage material between its slide face and the slide clamp nut
slide_nut_roof = 1.5;
// Steel: M4 x 12 slide clamp bolts ...
slide_bolt_len = 12;
// ... under M4 fender washers DIN 9021 (12 mm OD, 0.8 .. 1.2 thick)
slide_washer_t = 1.0;
// Bottom carriage plate thickness
bc_t        = 6;
// Bottom slide slots sit this far above the slide centre (the clamp heads are then in a front X-brace window: asserted)
bot_slot_shift = 4.5;
// Serrations between the bottom slide and its carriage: the camera weight is held by teeth, not clamp friction
// (Z then indexes in serr_pitch steps; false = smooth, friction only)
bot_serr    = true;
// Serration pitch = Z index step (45° teeth)
serr_pitch  = 2;
// Serration tooth height (peak to valley)
serr_depth  = 1;

/* [Lid, hood and shims] */
// Lid plate thickness
lid_t       = 5;
// Lid plate left under the top pockets (light-tight, flocked underneath)
lid_skin    = 2.0;
// Lid rib height
lid_rib_h   = 6;
// ISO 518 cold shoe: slot width
shoe_w      = 18.8;
// Cold shoe slot height
shoe_h      = 2.2;
// Cold shoe throat width
shoe_throat = 12.6;
// Cold shoe length
shoe_len    = 20;
// Cold shoe lip thickness
shoe_lip    = 3.0;
// Cold shoe side walls
shoe_wall   = 5.0;
// Optional hood length
hood_len    = 25;
// Hood wall thickness
hood_wall   = 2.0;
// shim_set thicknesses (camera <-> F38 plate)
shim_t      = [0.5, 1, 2];

/* [Printer] */
// Printer build volume [X, Y, Z]; every large part is checked against it
bed_limit   = [250, 250, 245];

/* [Resolution] */
// Facets: small holes
fn_small = 24;
// Facets: bosses, grips, lens envelopes
fn_big   = 64;
// Printed threads: facets per turn (helical-grid polyhedron, see thread_rod())
fn_thr   = 64;

/* [Hidden] */
// --- DERIVED VALUES (computed; do not edit) ---
// camera vectors: [W (X), H, D (incl. grip), axis height above tripod face, flange->tripod-socket, flange->rear LCD]
cam_a6400 = concat(a6400_size, a6400_meas);
cam_a5100 = concat(a5100_size, a5100_meas);
swap_shim_t = cam_a6400[3] - cam_a5100[3];
s2   = sqrt(2);
eps  = 0.01;

nut_ch_w  = sqnut_w + 2 * nut_clear;
nut_ch_h  = sqnut_t + 0.5 + bolt_runout;
hw_p      = hardware == "printed";
t8_clear  = t8_d + 0.6;
tn_w      = hw_p ? tnut[0] : sqnut_w;
tn_l      = hw_p ? tnut[1] : sqnut_w;
tn_t      = hw_p ? tnut[2] : sqnut_t;
tn_top_w  = hw_p ? neck_w + 0.4 : sqnut_w;
tn_ch_w   = tn_w + 2 * nut_clear;
tn_ch_l   = tn_l + 2 * nut_clear;
cl_d      = hw_p ? t8_clear : m4_clear;
ch_r      = hw_p ? cs_head[0] / 2 : m4_head_d / 2;
sl_slot_w = hw_p ? t8_clear : m4_clear;
sl_edge   = hw_p ? 3.0 : 3.5;
sl_stack  = hw_p ? sn_size[1] : slide_washer_t + m4_head_h;
sl_flange = hw_p ? sn_size[0] : 12;
wrl_clr   = hw_p ? t8_clear : m4_clear;
wrl_hd    = hw_p ? wb_head[0] + 0.6 : m4_head_d;
wrl_hh    = hw_p ? wb_head[1] : m4_head_h;
wrl_half  = hw_p ? 100 : inner_hw + wall_t;
pin_hole  = pin_d + pin_clr;
pin_phole = pin_d + pin_press;
unc_P     = 25.4 / 20;

function tan_h(f)      = sensor_w / 2 / f;
function tan_v(f, asp) = (asp == "3:2" ? sensor_h32 : sensor_h169) / 2 / f;

R15   = lens_15[0] / 2;
R1018 = lens_1018[0] / 2;
L15   = lens_15[1];
L1018 = lens_1018[1];
tv_t  = tan_v(target_f, target_aspect);
th_t  = tan_h(target_f);
wall_out = inner_hw + wall_t;

// Lens rim at y=-R outside the other camera's half-angle theta seen from
// pupil distance D = g + ep:  tan(theta) <= (g - m) / (g + ep + R).
// The rear lens sits on the uncoated side -> the glass thickness is added.
function g_min_for(R, ep, extra) =
    max(R + (plate_clear_min + extra) * s2,
        (rim_margin + tv_t * (ep + R)) / (1 - tv_t));
// The bottom lens wears a screw-in IR filter: a ring of radius Rfilt reaching filt_len beyond the bare front.
// Its front rim sits filt_len closer to the glass (g - filt_len) but ep_1018 is still measured from the bare front,
// so the pupil (and D) do not move with it: the filter rim is a second, narrower "lens rim" nearer the plate.
Rfilt = filt_od / 2;
function g_min_filt(Rf, fl, ep) = fl + max(Rf + plate_clear_min * s2, (rim_margin + tv_t * (fl + ep + Rf)) / (1 - tv_t));
g_min_rear = g_min_for(R15,   ep_15,   plate_t);
g_min_bot  = max(g_min_for(R1018, ep_1018, 0), g_min_filt(Rfilt, filt_len, ep_1018));
g_min      = max(g_min_rear, g_min_bot);
// common pupil distance D: each lens front at least g (design) and its own g_min
D          = max(max(g, g_min_rear) + ep_15, max(g, g_min_bot) + ep_1018);
g_rear     = D - ep_15;
g_bot      = D - ep_1018;

// --- rear camera (a6400, looks -Y) on carriage + f38_slide + F38 stack ---
cam_r      = cam_a6400;
y_rear_front = g_rear;
y_rear_mount = g_rear + L15;
y_rear_sock  = y_rear_mount + cam_r[4];
z_rear_tripod = Zs - cam_a6400[3];
deck_top   = z_rear_tripod - f38_stack - t_slide - t_rear_carriage;
y_rrail    = g + rear_travel / 4 + L15 + cam_r[4];
rear_slot_off = y_rear_sock - y_rrail;
deck_y0    = y_rrail - rc_width / 2;
split_y    = deck_y0 - 1;   // frame_split cut (1 mm ahead of the deck face: avoids a coplanar Nef cut)

// --- bottom camera (a5100, looks +Z, tripod face toward +Y) ---
cam_b      = cam_a5100;
z_bot_front = Zs - g_bot;
z_bot_filt  = z_bot_front + filt_len;
z_bot_mount = z_bot_front - L1018;
z_bot_sock  = z_bot_mount - cam_b[4];
bc_y0      = cam_a6400[3] + f38_stack + t_slide;
bc_yb      = bc_y0 + bc_t;
y_wf       = bc_yb;
y_cwm      = y_wf + wrl_t;
y_cwb      = y_cwm + cw_band_t;
function bot_sock_hi(c)  = Zs - g - L1018 - c[4];
function bot_sock_low(c) = bot_sock_hi(c) - bot_travel;
z_bsock_hi = max([for (c = [cam_a6400, cam_a5100]) bot_sock_hi(c)]);
z_bsock_lo = min([for (c = [cam_a6400, cam_a5100]) bot_sock_low(c)]);
bot_slot_trav = z_bsock_hi - z_bsock_lo;
bc_slot_c  = (z_bsock_hi + z_bsock_lo) / 2;
bot_slot_off = z_bot_sock - bc_slot_c;
bc_bolt_z  = bc_slot_c + bot_slot_shift;
function bot_lcd_low(c)   = Zs - g - bot_travel - L1018 - c[5];

// --- F38 slides ---
slide_bolt_x = f38_base[0] / 2 + 7;
slide_hw     = slide_bolt_x + sl_slot_w / 2 + sl_edge;
serr_wx      = slide_hw - slide_bolt_x + 5 + (hw_p ? 0 : 1);
function slide_len(travel) = max(f38_base[1] + 4, travel + sl_slot_w + 8);
tongue_h     = guide_d - 0.2;
qtr_cb_top   = -tongue_h + qtr_head_h + 0.3;
slide_nut_d  = slide_nut_roof + (sqnut_t + 0.4) / 2;
slide_tip_d  = slide_bolt_len - t_slide - slide_washer_t;

// --- CROSSWALL + bottom carriage (world) ---
bc_z0      = z_bsock_lo - slide_len(bot_slot_trav) / 2 - 1;
bc_z1      = max(z_bsock_hi + slide_len(bot_slot_trav) / 2 + 1, wr_z + wr_off + dowel_hole / 2 + 2);
cw_top     = bc_z1 + 1 + wr_scale_h + 1;
// crosswall + bottom carriage (y >= bc_y0, z <= cw_top) vs the frusta: vertical distance outside the rear frustum
// (15 mm, full 3:2 sensor = widest the rear camera ever sees; 0 if behind its pupil) and horizontal (Y) distance
// outside the bottom frustum (target frame).  Independent of stereo (the cameras move in X only).
m_wall_rear = (Zs - cw_top) - max(0, D - bc_y0) * tan_v(15, "3:2");
m_wall_bot  = bc_y0 - max(0, cw_top - (Zs - D)) * tan_v(fov_f_bot, fov_aspect);
function z_rib_lo(y) = Zs + s2 * w_rib_lo - y;
z_wrl0     = wr_z + wrl_lo;
z_wseat    = z_wrl0 - wrl_gap;
wclamp_tip = wclamp_bolt_len - clamp_seat;
wrl_cb     = wrl_hh + 0.3;
wrl_nut_u  = [wrl_t + wrl_nut_f, wrl_t + wrl_nut_f + tn_t];
wrl_tip_u  = wrl_cb + wrl_bolt_len;
wrl_rib_clr = 1;
// tripod socket pad: ONE socket (1/4"-20, or 3/8"-16 with tri_38) in a round pad in the crosswall foot, just behind
// the wall front face; top of the pad; floor height under a y-range.  tripod_mount: "insert" (heat-set insert),
// "printed" (printed 1/4"-20 UNC in a deeper 20 mm boss), "arca" (no socket; 2 printed M10 threads in bosses for
// the printed Arca-Swiss plate)
tri_pr      = tripod_mount == "printed";
tri_arca    = tripod_mount == "arca";
tri_ins_d   = tri_pr ? unc_minor : tri_38 ? ins38_d : ins14_d;
tri_ins_dep = tri_pr ? tri_thr_depth : tri_38 ? ins38_depth : tri_ins_depth;
tri_pad_dd  = tri_pr ? 20 : (tri_38 && !tri_arca) ? ins38_d + 8 : tri_pad_d;
tri_xy      = [tri_x, y_wf + tri_pad_dd / 2 + tri_gap];
tri_pad_top = max(base_t, tri_ins_dep + tri_roof);
function pad_under(y0, y1) = tri_xy[1] + tri_pad_dd / 2 > y0 && tri_xy[1] - tri_pad_dd / 2 < y1;
function floor_under(y0, y1) = pad_under(y0, y1) ? tri_pad_top : base_t;

// --- glass groove cross-section (x = |X|, w = plate normal) ---
x_lip  = plate_size / 2 - glass_engage;
// upper flank inner edge: x_lip + ul_off at groove_w <= 3.2; a wider groove raises the roof, so the
// edge moves outboard 0.5 per mm of extra width (keeps the lid-view margin)
function x_ul_of(gw) = x_lip + ul_off + max(0, gw - 3.2) / 2;
x_ul   = x_ul_of(groove_w);
x_gb   = plate_size / 2 + edge_float;
x_rw   = inner_hw + 1;
w_lo   = -felt_t;
function w_hi_of(gw) = w_lo + gw;
function w_back_of(gw) = w_hi_of(gw) + back_flank;
w_hi   = w_hi_of(groove_w);
w_back = w_back_of(groove_w);
w_fl   = -lip_proud;
function w_front(x) = x <= x_lip + lip_flat ? w_fl : w_fl - (x - x_lip - lip_flat) / bevel_k;
function w_upper(x, gw = groove_w) = min(w_back_of(gw), w_hi_of(gw) + max(0, x - x_ul_of(gw)) / bevel_k);
w_fr_rw = w_front(x_rw);
v_es   = plate_size / 2 + end_pad;
v_bot  = v_es + end_t;
v_top  = -(plate_size / 2 + end_pad + stop_gap);
w_seat   = w_fl;
x_gb_s   = strip_glass[0] / 2 + edge_float;
v_es_s   = strip_glass[1] - plate_size / 2 + end_pad;
v_s0     = v_top + strip_clr;
v_s1     = v_es + strip_cap;
v_ch_end = v_s1 + strip_clr;
xo_s     = x_ch - strip_side_clr;
sn_half  = ps_d / 2 + 1.5;
sb_h     = strip_top_clr + spring_bump;
sb_run   = 3;
x_sb   = 81.5;  w_sb = 1;   // counterbore (8.5) keeps >= 0.6 wall to the stop's outer face (asserted)
v_seat = v_top - stop_len + m4_head_h;
v_sbnut = v_seat + stop_bolt_len - 0.5 - (sqnut_t + 0.4) / 2;
function boss_r()  = preload_type == "printed" ? ps_d / 2 + ps_clear + ps_wall : nut_ch_w / 2 + 1.2;
boss_x0 = x_pl - boss_r();
boss_l  = 2 * boss_r();
diag_w_up = [w_fr_rw - 0.6, w_back];
w_rib_lo  = min(diag_w_lo[0], diag_w_up[0]);
// rib gusset length: gusset_max, or less so its end stays 3 mm above the crosswall top (z_rib_lo() at its end)
gusset_len = min(gusset_max, s2 * (Zs + s2 * w_rib_lo - cw_top - 3) - v_bot - w_rib_lo);

function pz(v, w) = (w - v) / s2;
function py(v, w) = (v + w) / s2;
top_rel = max([pz(-plate_size / 2, plate_t), pz(v_top, w_back), pz(v_top - stop_len, stop_w[1]),
               for (p = preload_v) pz(p - boss_l / 2, w_hi + boss_h)]);
frame_top = ceil(Zs + top_rel + lid_clear);
rib_front_y  = py(v_top, diag_w_up[0]);
stop_clip_y  = y_front + front_margin;               // glass_stop is clipped to world y >= this
sear_y1      = stop_clip_y + 11;                     // printed: glass_stop ear inboard part only at y <= this
sb_pd        = sb_head[1] + 0.2;

// --- front aperture: posts flare so the target frustum stays clear ---
x_front_in = max(inner_hw, (D - y_front) * th_t + aperture_margin);
y_flare    = min(-30, D - (inner_hw - aperture_margin) / th_t);
x_col_out  = x_front_in + col_w;
z_ap_lo    = Zs - (D - y_front) * tv_t - aperture_margin;
z_ap_hi    = Zs + (D - y_front) * tv_t + aperture_margin;

// --- rail T-slot geometry (nut: tn_* see the top of this section) ---
nut_top_z   = -(key_d + neck_d) - (tn_top_w - neck_w) / 2;
tslot_depth = hw_p ? -nut_top_z + tn_t + 0.5 + bolt_runout + 1.5
                   : key_d + neck_d + (nut_ch_w - neck_w) / 2 + nut_ch_h;
clamp_tip_z = clamp_seat - clamp_bolt_len;

// --- lid bolt positions [x, y] (mirrored in X): front posts, rear posts ---
col_yc     = y_front + col_d / 2;
col_x_bolt = x_front_in + col_w / 2;
rp_xc      = (rp_x0 + wall_out) / 2;
rp_yc      = (rp_y[0] + rp_y[1]) / 2;
lid_y0 = y_front;
lid_y1 = y_zone_end;
fp_x0      = inner_hw;
fp_x1      = x_col_out + 2;
lid_hw     = hw_p ? fp_x1 : x_col_out;
lid_bolts  = hw_p ? [[(fp_x0 + fp_x1) / 2, y_front + col_d + 7], [(rp_x0 + x_col_out) / 2, lid_y1 - 8]]
                  : [[col_x_bolt, col_yc], [rp_xc, rp_yc]];
thr_r      = ps_d / 2 + ps_clear;
lid_thr    = [lid_sl - lid_t - ear_t + 2, lid_sl - lid_t + 2];
fp_top     = frame_top - (hw_p ? ear_t : 0);
fp_y1      = lid_bolts[0][1] + thr_r + 3;
fp_z0      = fp_top - lid_thr[0] - 0.5 - 2 - (lid_bolts[0][1] + thr_r - (y_front + col_d));
                                                     // back face; 45° up to fp_y1 -> >= 2 under the thread everywhere
rp_py0     = lid_bolts[1][1] - thr_r - 3;
rpz0       = frame_top - lid_thr[1] - 0.5 - 2 - max(0, lid_bolts[1][0] + thr_r - wall_out, rp_y[0] - (lid_bolts[1][1] - thr_r));

// --- plate coverage ---
h_plate = plate_size / 2 - glass_engage;
function cov_ok(f, asp, d) =
    let(tv = tan_v(f, asp), th = tan_h(f))
    (s2 * d * tv / (1 - tv) <= h_plate) && (d * th / (1 - tv) <= h_plate);
function f_min_cov(asp, d) = [for (f = [8 : 0.1 : 80]) if (cov_ok(f, asp, d)) f][0];

// --- lens rim vs other camera's frustum ---
rim_ang_bot_lens  = atan((g_bot  - rim_margin) / (D + R1018)); // rear cam must stay inside this (bare barrel rim)
rim_ang_bot_filt  = atan((g_bot - filt_len - rim_margin) / (D + Rfilt));
rim_ang_rear_lens = atan((g_rear - rim_margin) / (D + R15));   // bottom cam must stay inside this
theta_v_target    = atan(tv_t);

// --- lens <-> glass clearance measured normal to the plate ---
clr_rear_plate = (g_rear - R15) / s2 - plate_t;
clr_bot_plate  = min((g_bot - R1018) / s2, (g_bot - filt_len - Rfilt) / s2);

// --- frusta vs rib / lips / stops / bosses / heads (pinhole pupils, target frame) ---
// A plate-local point p = [x, v, w] -> world; margin = distance (mm, lateral)
// outside the rear camera's straight frustum and the bottom camera's straight
// frustum.  At stereo 0 the straight frusta cover everything: the rear camera's
// reflected view (upward, the "lid view") coincides with the bottom one's, and vice
// versa.  In stereo the lid views shift with the pupils -> see the clipping readout.
function pl2w(p) = [p[0], (p[1] + p[2]) / s2, Zs + (p[2] - p[1]) / s2];
function m_rear(P) = let(d = D - P[1]) d <= 1 ? 999 : max(abs(P[0]) - d * th_t, abs(P[2] - Zs) - d * tv_t);
function m_bot(P)  = let(d = P[2] - (Zs - D)) d <= 1 ? 999 : max(abs(P[0]) - d * th_t, abs(P[1]) - d * tv_t);
function m_pt(p) = let(P = pl2w(p)) min(m_rear(P), m_bot(P));
function min_m(pts) = min([for (p = pts) m_pt(p)]);
v_samp  = [for (v = [v_top : 0.1 : v_bot]) v];
x_bev   = [for (t = [0 : 1 / 16 : 1]) x_lip + lip_flat + t * (x_rw - x_lip - lip_flat)];
x_bevu  = [for (t = [0 : 1 / 16 : 1]) x_ul + t * (x_rw - x_ul)];
m_lower = min_m([for (v = v_samp) each concat([[x_lip, v, w_fl]], [for (x = x_bev) [x, v, w_front(x)]])]);
m_upper = min_m([for (v = v_samp) each concat([[x_lip, v, w_lo], [x_ul, v, w_hi]], [for (x = x_bevu) [x, v, w_upper(x)]])]);
m_boss  = min_m([for (p = preload_v, dv = [-boss_l / 2 : boss_l / 8 : boss_l / 2], w = [w_hi : boss_h / 8 : w_hi + boss_h]) [boss_x0, p + dv, w]]);
ph_r    = preload_type == "printed" ? ps_head[0] / 2 : m4_head_d / 2;
ph_w    = preload_type == "printed" ? [w_hi + boss_h + 2 - 0.7, w_hi + boss_h + 2 + ps_head[1]] : [w_hi + boss_h - 0.7, w_hi + boss_h + m4_head_h];
m_head  = min_m([for (p = preload_v, a = [0 : 5 : 355], w = [ph_w[0], ph_w[0] + 0.7, ph_w[1]]) [x_pl + ph_r * cos(a), p + ph_r * sin(a), w]]);
m_stop  = min_m([for (v = [v_top - stop_len : stop_len / 8 : v_top], w = [stop_w[0] : 0.5 : stop_w[1]], x = [stop_x0, x_rw]) [x, v, w]]);
m_side  = min_m([for (v = [v_top : 0.5 : v_bot + 120], w = [diag_w_up[0], w_rib_lo]) [inner_hw, v, w]]);
m_foam  = min_m([for (v = v_samp, w = [plate_t, w_hi]) [x_ul, v, w]]);
m_tip   = min_m([for (p = preload_v, dv = [-ps_d / 2 : ps_d / 8 : ps_d / 2]) [x_pl - ps_d / 2, p + dv, plate_t]]);

// --- stereo: bottom lens front rim vs the rib underside (plate-local w of a rim point vs the lower flank; the rim is
//     the barrel's highest-w part, so the rim check covers the whole bottom lens) ---
function wloc(y, z) = (y + z - Zs) / s2;
clr_bot_rib = min([for (rz = [[R1018, z_bot_front], [Rfilt, z_bot_filt]], a = [0 : 5 : 355])
                   let(x = abs(-bot_stereo + rz[0] * cos(a)), y = rz[0] * sin(a))
                   x > x_lip ? w_front(x) - wloc(y, rz[1]) : 99]);
// Rear lens: the WHOLE barrel (not only its front rim: a thumbscrew head can sit beside the barrel in stereo)
// vs the +X rib's upper flank, every preload boss (all faces, 0.5 mm grid) and every thumbscrew head
// (discs at the bottom / tightened / top), as signed distances to the finite lens cylinder at x = sx (the -X side is
// the mirror image).  Real lens (>= 2 asserted) and its clearance envelope (+3 radius, +5 each end; >= 0 asserted).
function rng(a, b, st) = [for (i = [0 : ceil((b - a) / st - 1e-9)]) min(b, a + i * st)];
function d_lens(P, sx, R, y0, y1) = let(r = norm([P[0] - sx, P[2] - Zs]), Y = P[1])
    (Y >= y0 && Y <= y1) ? (r >= R ? r - R : -min([R - r, Y - y0, y1 - Y]))
                         : let(dy = Y < y0 ? y0 - Y : Y - y1) (r <= R ? dy : norm([r - R, dy]));
function box_pts(x0, x1, v0, v1, w0, w1, st = 0.5) = let(xs = rng(x0, x1, st), vs = rng(v0, v1, st), ws = rng(w0, w1, st)) concat(
    [for (x = [x0, x1], v = vs, w = ws) [x, v, w]], [for (v = [v0, v1], x = xs, w = ws) [x, v, w]],
    [for (w = [w0, w1], x = xs, v = vs) [x, v, w]]);
lens_pts = concat(
    [for (p = preload_v) each box_pts(boss_x0, x_rw, p - boss_l / 2, p + boss_l / 2, w_hi, w_hi + boss_h)],
    [for (p = preload_v, w = [ph_w[0], ph_w[0] + 0.7, ph_w[1]], r = [ph_r, ph_r * 2 / 3, ph_r / 3, 0], a = [0 : 5 : 355])
        [x_pl + r * cos(a), p + r * sin(a), w]],
    [for (x = rng(x_ul, x_rw, 1), v = rng(v_top, v_bot, 1)) [x, v, w_upper(x)]]);
function clr_rear_lens(sx, grow = 0) = min([for (q = lens_pts)
    d_lens(pl2w(q), sx, R15 + grow, y_rear_front - (grow > 0 ? lens_clear_l / 2 : 0), y_rear_mount + (grow > 0 ? lens_clear_l / 2 : 0))]);
clr_rear_rib = clr_rear_lens(rear_stereo);
clr_rear_env = clr_rear_lens(rear_stereo, lens_clear_d / 2);
clr_rear_stereo = rp_x0 - (rear_stereo + R15);
clr_bot_stereo  = inner_hw - (bot_stereo + R1018);

// --- part sizes in print orientation (analytic, verified from STL output) ---
hood_x_far = (D - y_front + hood_len) * th_t + aperture_margin + hood_wall;
size_frame    = [2 * lid_hw, y_back - y_front, frame_top + (hw_p ? lid_pin_up : 0)];
size_lid      = [2 * lid_hw, lid_y1 - lid_y0, lid_t + lid_rib_h + shoe_h + shoe_lip + 1];
size_wrl      = [2 * wrl_half, cw_top - (wr_z + wrl_lo), wrl_t];
size_hood     = [2 * hood_x_far, hood_len + 4, 2 * ((D - y_front + hood_len) * tv_t + aperture_margin + hood_wall)];

// --- Stereo clipping readout ---
//  Pinhole rays over a clip_grid of the target frame (target_f, target_aspect) from each pupil; rear = transmitted,
//  bottom = reflected by the coated face.  Every pixel carries TWO views:
//   * SCENE legs (pupil -> plate -> out of the front): the ray is CLIPPED if it
//     meets the plate outside the clear aperture (+-h_plate) or crosses any
//     obstacle on its way; for a WRAPPED rig also if it leaves through the side
//     plane (= hits the wrap on its outer face) before the front face;
//   * the LID-VIEW leg: from the coated-face point P straight up, direction
//     (u th, -s tv, 1) for BOTH cameras (rear: 50 % reflection, bottom: 50 %
//     transmission).  At stereo 0 it lands on the flocked lid underside; in stereo
//     it shifts with the pupil.  First hit on another part (flank, boss,
//     thumbscrew head, stop, post, rear lens) = "part" (imaged at 50 %: flock /
//     paint it matt black); missing the lid = "outside" (sees the world through
//     the open truss: the side wrap stops it).
//  Crops (largest centred crop, same aspect, clean in BOTH images): "wrapped" = scene
//  legs + wrap; "unwrapped" = scene legs | lid view sees a part | lid view outside.
//  Obstacles are convex solids = lists of half-spaces [nx, ny, nz, c] (inside:
//  n.p <= c).  Same geometry in tools/stereo_clip.py (an independent re-implementation
//  with exact cylinders, used as a cross-check).
function hs_box(lo, hi) = [[1, 0, 0, hi[0]], [-1, 0, 0, -lo[0]], [0, 1, 0, hi[1]], [0, -1, 0, -lo[1]],
                           [0, 0, 1, hi[2]], [0, 0, -1, -lo[2]]];
// plate-local half-space a x + b v + c w <= k  ->  world
function hs_pl(a, b, c, k) = [a, (b + c) / s2, (c - b) / s2, k - (b - c) * Zs / s2];
function hs_plpoly(pts, v0, v1, sx = 1) = concat(
    [for (i = [0 : len(pts) - 1]) let(p = pts[i], q = pts[(i + 1) % len(pts)], nx = q[1] - p[1], nw = p[0] - q[0])
        hs_pl(sx * nx, 0, nw, nx * p[0] + nw * p[1])],
    [hs_pl(0, 1, 0, v1), hs_pl(0, -1, 0, -v0)]);
function hs_plbox(x0, x1, v0, v1, w0, w1, sx = 1) = hs_plpoly([[x0, w0], [x1, w0], [x1, w1], [x0, w1]], v0, v1, sx);
function hs_xypoly(pts, z0, z1) = concat(
    [for (i = [0 : len(pts) - 1]) let(p = pts[i], q = pts[(i + 1) % len(pts)], nx = q[1] - p[1], ny = p[0] - q[0])
        [nx, ny, 0, nx * p[0] + ny * p[1]]],
    [[0, 0, 1, z1], [0, 0, -1, -z0]]);
function hs_mirror_x(H, sx = -1) = [for (h = H) [sx * h[0], h[1], h[2], h[3]]];
function hs_cyl_y(x0, z0, R, y0, y1, n = 16) = concat([for (k = [0 : n - 1]) let(a = 360 * k / n)
    [cos(a), 0, sin(a), x0 * cos(a) + z0 * sin(a) + R / cos(180 / n)]], [[0, 1, 0, y1], [0, -1, 0, -y0]]);
function hs_cyl_z(x0, y0, R, z0, z1, n = 16) = concat([for (k = [0 : n - 1]) let(a = 360 * k / n)
    [cos(a), sin(a), 0, x0 * cos(a) + y0 * sin(a) + R / cos(180 / n)]], [[0, 0, 1, z1], [0, 0, -1, -z0]]);
function hs_cyl_w(x0, v0, R, w0, w1, n = 16) = concat([for (k = [0 : n - 1]) let(a = 360 * k / n)
    hs_pl(cos(a), sin(a), 0, x0 * cos(a) + v0 * sin(a) + R / cos(180 / n))], [hs_pl(0, 0, 1, w1), hs_pl(0, 0, -1, -w0)]);
function hs_hood() = let(y1 = y_front - hood_len, zr = [Zs - 200, Zs + 200]) [
    for (s = [-1, 1]) concat([[-s, -th_t, 0, -(aperture_margin + th_t * D)], [s, th_t, 0, aperture_margin + hood_wall + th_t * D]],
                              [[0, 1, 0, y_front], [0, -1, 0, -y1], [0, 0, 1, zr[1]], [0, 0, -1, -zr[0]]]),
    for (s = [-1, 1]) concat([[0, -tv_t, -s, -(aperture_margin + tv_t * D) - s * Zs], [0, tv_t, s, aperture_margin + hood_wall + tv_t * D + s * Zs]],
                              [[0, 1, 0, y_front], [0, -1, 0, -y1], [1, 0, 0, 300], [-1, 0, 0, 300]])];
function clip_upper(sx) = [
    hs_plpoly([[x_ul, w_hi], [x_rw, w_hi], [x_rw, w_back], [x_ul + (w_back - w_hi) * bevel_k, w_back]], v_top, v_bot, sx),
    hs_plbox(x_gb, x_rw, v_top, v_bot, w_lo, w_hi, sx),
    hs_plbox(x_ul, x_gb, v_top, v_es, plate_t, w_hi, sx),
    hs_plbox(stop_x0, inner_hw - 0.3, v_top - stop_len, v_top, stop_w[0], stop_w[1], sx),
    hs_plbox(inner_hw, wall_out, v_top, v_bot, diag_w_up[0], diag_w_up[1], sx),
    for (p = preload_v) each [
        hs_plbox(boss_x0, x_rw, p - boss_l / 2, p + boss_l / 2, w_hi, w_hi + boss_h, sx),
        hs_mirror_x(hs_cyl_w(x_pl, p, ph_r, ph_w[0], ph_w[1], 32), sx),
        hs_mirror_x(hs_cyl_w(x_pl, p, ps_d / 2, plate_t, ph_w[0], 32), sx)],
    hs_mirror_x(hs_xypoly([[inner_hw, max(y_flare, y_front)], [x_front_in, y_front], [x_col_out, y_front],
               [x_col_out, y_front + col_d], [inner_hw, y_front + col_d]], 0, frame_top), sx),
    hs_box([min(sx * rp_x0, sx * wall_out), rp_y[0], 0], [max(sx * rp_x0, sx * wall_out), rp_y[1], frame_top]),
    if (hw_p) each [
        hs_mirror_x(concat(hs_box([fp_x0, y_front + col_d, fp_z0], [fp_x1, fp_y1, frame_top]), [[0, 1, -1, y_front + col_d - fp_z0]]), sx),
        hs_mirror_x(hs_box([x_col_out, y_front, fp_top - (fp_x1 - x_col_out)], [fp_x1, y_front + col_d, frame_top]), sx),
        hs_mirror_x(hs_box([stop_x0, stop_clip_y, fp_top], [fp_x0, sear_y1, frame_top]), sx),
        hs_mirror_x(concat(hs_box([rp_x0, rp_y[0], rpz0], [x_col_out, y_zone_end, frame_top]), [[1, 0, -1, wall_out - rpz0]]), sx),
        hs_mirror_x(concat(hs_box([inner_hw, rp_py0, rpz0], [x_col_out, rp_y[0], frame_top]),
                           [[0, -1, -1, -(rpz0 + rp_y[0])], [1, 0, -1, wall_out - rpz0]]), sx)]];
lid_box = hs_box([-lid_hw, lid_y0, frame_top], [lid_hw, lid_y1, frame_top + lid_t + lid_rib_h]);
function clip_obstacles(sr, sb, cam) = concat(
    [for (sx = [-1, 1]) each concat([
        hs_plbox(x_lip, x_lip + lip_flat, v_top, v_bot, w_fl, w_lo, sx),
        hs_plpoly([[x_lip + lip_flat, w_fl], [x_rw, w_front(x_rw)], [x_rw, w_lo], [x_lip + lip_flat, w_lo]], v_top, v_bot, sx),
        hs_plbox(x_lip, x_rw, v_es, v_bot, w_lo, w_hi, sx),
        hs_plbox(inner_hw, wall_out, v_bot, v_bot + 250, w_rib_lo, diag_w_lo[1], sx)],
        clip_upper(sx))],
    [lid_box,
     hs_box([-wall_out, y_front, 0], [wall_out, y_back, base_t]),
     hs_box([-brace_x - 1, brace_y0, 0], [brace_x + 1, brace_y1, brace_top_z]),
     hs_box([-wall_out, y_wf, 0], [wall_out, y_cwb, cw_top]),
     hs_box([-wall_out, deck_y0, deck_top - rail_band_d], [wall_out, y_back, deck_top])],
    cam == "rear" ? [hs_cyl_z(-sb, 0, R1018, z_bot_mount, z_bot_front), hs_cyl_z(-sb, 0, Rfilt, z_bot_front - 1, z_bot_filt)]
                  : [hs_cyl_y(sr, Zs, R15, y_rear_front, y_rear_mount)],
    show_hood ? hs_hood() : []);
function lid_view_parts(sr) = concat(clip_upper(-1), clip_upper(1), [hs_cyl_y(sr, Zs, R15, y_rear_front, y_rear_mount)]);
function seg_t(o, d, t0, t1, H) = let(
    dn = [for (h = H) h[0] * d[0] + h[1] * d[1] + h[2] * d[2]],
    nm = [for (h = H) h[3] - (h[0] * o[0] + h[1] * o[1] + h[2] * o[2])],
    out = [for (i = [0 : len(H) - 1]) if (abs(dn[i]) < 1e-12 && nm[i] < 0) 1],
    ta = max(concat([t0], [for (i = [0 : len(H) - 1]) if (dn[i] < -1e-12) nm[i] / dn[i]])),
    tb = min(concat([t1], [for (i = [0 : len(H) - 1]) if (dn[i] > 1e-12) nm[i] / dn[i]])))
    (len(out) == 0 && ta < tb - 1e-9) ? ta : 1e9;
function seg_hits(o, d, t0, t1, H) = seg_t(o, d, t0, t1, H) < 1e8;
function any_hit(o, d, t0, t1, obs, i = 0) = i >= len(obs) ? false
    : seg_hits(o, d, t0, t1, obs[i]) ? true : any_hit(o, d, t0, t1, obs, i + 1);
y_far = y_front - hood_len - 20;
function ray_clip(cam, u, s, sr, sb, obs, lobs) = let(
    rear = cam == "rear",
    o  = rear ? [sr, D, Zs] : [-sb, 0, Zs - D],
    d  = rear ? [u * th_t, -1, s * tv_t] : [u * th_t, -s * tv_t, 1],
    tp = D / (1 - s * tv_t),
    P  = o + tp * d,
    vP = (P[1] - P[2] + Zs) / s2,
    tb = rear ? (D - plate_t * s2) / (1 - s * tv_t) : tp,
    ep = rear ? ep_15 : ep_1018,
    r  = [u * th_t, -1, s * tv_t],
    scene = abs(P[0]) > h_plate || abs(vP) > h_plate
            || any_hit(o, d, ep, tb - 1e-6, obs) || any_hit(P, r, 1e-6, P[1] - y_far, obs),
    tw = abs(r[0]) < 1e-9 ? 1e9 : (sign(r[0]) * wall_out - P[0]) / r[0],
    wrap = !scene && P[1] - tw > y_front && P[2] + tw * r[2] > 0 && P[2] + tw * r[2] < frame_top,
    l  = [u * th_t, -s * tv_t, 1],
    te = frame_top + lid_t + lid_rib_h + 1 - P[2],
    tl = scene ? 1e9 : seg_t(P, l, 1e-6, te, lid_box),
    lid = scene ? 0 : any_hit(P, l, 1e-6, min(tl, te), lobs) ? 1 : (tl < 1e8 ? 0 : 2))
    [scene ? 1 : 0, wrap ? 1 : 0, lid];
function clip_map(cam, sr, sb) = let(obs = clip_obstacles(sr, sb, cam), lobs = lid_view_parts(sr),
                                     nx = clip_grid[0], ny = clip_grid[1])
    [for (j = [0 : ny - 1], i = [0 : nx - 1]) let(u = -1 + (2 * i + 1) / nx, s = -1 + (2 * j + 1) / ny)
        concat([u, s], ray_clip(cam, u, s, sr, sb, obs, lobs))];
function cheb(bad) = min(concat([1], [for (r = bad) max(abs(r[0]), abs(r[1]))]));
function clip_stats(m) = let(nx = clip_grid[0], ny = clip_grid[1], stop = 1 - 1 / ny,
    wb = [for (r = m) if (r[2] == 1 || r[3] == 1) r],
    ub = [for (r = m) if (r[2] == 1 || r[4] > 0) r])
    [100 * len(wb) / len(m), 100 * len([for (r = wb) if (r[1] >= stop - 1e-9) r]) / nx, cheb(wb),
     100 * len([for (r = m) if (r[2] == 0 && r[4] == 1) 1]) / len(m),
     100 * len([for (r = m) if (r[2] == 0 && r[4] == 2) 1]) / len(m), cheb(ub)];

function seg_dist2d(p, a, b) = let(d = b - a, t = max(0, min(1, ((p - a) * d) / (d * d)))) norm(p - (a + t * d));
function brace_clear(x, z) = min([for (s = [-1, 1]) each [
    seg_dist2d([x, z], [s * brace_x, brace_z0 - 3], [0, brace_z1]),
    seg_dist2d([x, z], [s * brace_x, brace_z1], [0, brace_z0 - 3])]]) - brace_w / 2;
function max_bolt(seat, floor_d) = seat + floor_d - 0.3;
// ... which stereo_bot index steps leave all four bottom clamp heads reachable straight from the front (key line >= 2.5
// from every brace member and from the post inner face); the other steps: from the open sides with an L-key
function key_ok(x, z) = brace_clear(x, z) >= 2.5 && abs(x) <= inner_hw - 2.5;
qtr_under   = t_slide - qtr_cb_top;
qtr_engage  = qtr_screw_len - qtr_under;
f38_pin_hole = f38_pin_d - 0.1;
function box_c(lo, sz) = [lo[0] + sz[0] / 2, lo[1] + sz[1] / 2, lo[2] + sz[2] / 2];
function mix2(a, va, b, vb) = (a * va + b * vb) / (va + vb);
cog_bought = let(cr = cam_r, cb = cam_b) [
    ["rear_body", mix2(box_c([-cr[0] / 2, y_rear_mount, z_rear_tripod], [cr[0], cr[5], cr[1]]), cr[0] * cr[5] * cr[1],
                       box_c([-cr[0] / 2, y_rear_mount - (cr[2] - cr[5]), z_rear_tripod], [28, cr[2] - cr[5], cr[1]]),
                       28 * (cr[2] - cr[5]) * cr[1]) + [stereo_rear, 0, 0]],
    ["rear_lens", [stereo_rear, y_rear_front + L15 / 2, Zs]],
    ["rear_f38",  [stereo_rear, y_rear_sock, z_rear_tripod - f38_stack / 2]],
    ["bot_body",  mix2(box_c([-cb[0] / 2, cb[3] - cb[1], z_bot_mount - cb[5]], [cb[0], cb[1], cb[5]]), cb[0] * cb[1] * cb[5],
                       box_c([cb[0] / 2 - 25, cb[3] - cb[1], z_bot_mount], [25, cb[1], cb[2] - cb[5]]), 25 * cb[1] * (cb[2] - cb[5]))
                  + [-stereo_bot, 0, 0]],
    ["bot_lens",  [-stereo_bot, 0, z_bot_mount + L1018 / 2]],
    ["bot_f38",   [-stereo_bot, bc_y0 - t_slide - f38_stack / 2, z_bot_sock]],
    ["glass",     [0, plate_t / 2 / s2, Zs + plate_t / 2 / s2]],
    ["bot_filter", [-stereo_bot, 0, z_bot_front + filt_len / 2]]];

// Summary first, so the margins are visible even when an assert below stops the run.
echo(str("\n==== BEAM-SPLITTER RIG SUMMARY ====",
    "\n HARDWARE: ", hardware, hw_p ? str(" -- printed M10 x 2 / M8 x 2 thumbscrews, T-nuts, thumb-nuts, bolts, pins O", pin_d,
    " (holes ", pin_hole, "), wrap clips, printed 1/4\"-20 UNC female threads (lid, side points)") : " -- M4 bolts, square nuts, steel dowels, inserts",
    "   tripod_mount: ", tripod_mount, tri_arca ? " (printed Arca plate, 2 x M10)" : tri_pr ? str(" (printed 1/4\"-20, ", tri_ins_dep, " deep)")
    : str(" (heat-set insert ", tri_38 ? "3/8\"-16" : "1/4\"-20", ")"),
    "\n TARGET FRAME: target_f = ", target_f, " mm ", target_aspect, " (default 19 = the smallest 0.5 mm step that passes",
    " with the default IR filter)   drawn frusta: rear ", fov_f_rear, " / bottom ", fov_f_bot, " mm",
    "\n measured inputs: axis a6400 ", cam_a6400[3], " / a5100 ", cam_a5100[3], ", f38_stack ", f38_stack,
    " (entered at the upper end of the reading: each camera errs low / toward its mount; the shim_set takes it up)",
    "   swap_shim ", swap_shim_t,
    "\n IR filter (bottom lens): O", filt_od, " x ", filt_len, " beyond the bare front -> filter front ", g_bot - filt_len,
    " from the plate centre (bare front ", g_bot, "; ep_1018 from the bare front)",
    "\n Zs = ", Zs, "   frame_top = ", frame_top, "   deck_top = ", deck_top, "   D = ", D,
    "\n g_min = ", g_min, " (rear ", g_min_rear, ", bottom ", g_min_bot, ")   g_rear = ", g_rear, "   g_bot = ", g_bot,
    "\n rear pupil match: slide offset ", rear_slot_off, " of +-", rear_travel / 2,
    "   bottom: ", bot_slot_off, " of +-", bot_slot_trav / 2, " (slot = ", bot_travel, " travel + both bodies' socket offsets)",
    "\n lens-plate clearance: rear ", clr_rear_plate, "  bottom ", clr_bot_plate, " (barrel ", (g_bot - R1018) / s2,
    ", IR filter ", (g_bot - filt_len - Rfilt) / s2, ")",
    "\n rim-clear angle (deg): bottom lens ", rim_ang_bot_lens, "  its IR filter ", rim_ang_bot_filt, "  rear lens ", rim_ang_rear_lens,
    "  target half-VFOV ", theta_v_target,
    "\n min full-coverage f (pinhole, h=", h_plate, "): 3:2 ", f_min_cov("3:2", D),
    "  16:9 ", f_min_cov("16:9", D),
    "\n frusta margins (pinhole, ", target_f, " mm ", target_aspect, ", stereo 0): lower lip ", m_lower,
    "  upper flank ", m_upper, "  bosses ", m_boss, "  thumbscrew heads ", m_head, "  screw tips ", m_tip, "  glass_stop ", m_stop,
    "  side plane ", m_side, "  roof felt edge ", m_foam, "  (0.1 mm sampling; upper felt strip ", x_gb - x_ul, " wide)",
    "\n stereo clearances at the rated travel (rear +-", rear_stereo, ", bottom +-", bot_stereo, "): rear lens-post ", clr_rear_stereo,
    "  rear lens (whole barrel) vs rib / bosses / thumbscrew heads ", clr_rear_rib, " (envelope ", clr_rear_env, ")",
    "  bottom lens-side ", clr_bot_stereo, "  bottom lens-rib ", clr_bot_rib,
    "\n STEREO CLIP (rear +", stereo_rear, ", bottom -", stereo_bot, "; split interaxial ", stereo_rear + stereo_bot,
    "; ", clip_grid[0], "x", clip_grid[1], " rays = +-", 200 / clip_grid[0], " % per column, ", target_f, " mm ", target_aspect,
    clip_run ? "" : clip_check ? " -- stereo 0: nothing clipped (asserted margins), rays not traced" : " -- clip_check OFF", "):",
    "\n   WRAPPED rig (scene legs; the side wrap is on): rear ", clip_r[0], " % area, ", clip_r[1], " % of top row   bottom ",
    clip_b[0], " % area, ", clip_b[1], " % of top row   common clean centred crop ", clip_k, " % (w and h)",
    "\n   lid views (50 % reflection / transmission, up to the lid): rear sees a part on ", clip_r[3], " %, the outside on ",
    clip_r[4], " %   bottom: part ", clip_b[3], " %, outside ", clip_b[4], " %   -> UNWRAPPED rig crop ", clip_ku, " %",
    "\n bottom position lowest LCD z: a6400 ", bot_lcd_low(cam_a6400), "  a5100 ", bot_lcd_low(cam_a5100),
    " (recess floor ", lcd_floor, ")",
    "\n front aperture half-width = ", x_front_in, " (flare from y=", y_flare, ")",
    "   z ", z_ap_lo, " .. ", z_ap_hi,
    "\n frame bbox = ", size_frame, "  top rel S = ", top_rel, "  rib front y = ", rib_front_y,
    "\n rear stack printed: carriage ", t_rear_carriage, " + slide ", t_slide, " = ", t_rear_carriage + t_slide,
    "   deck_top ", deck_top, "   rear lens bottom above the F38 plate top ", cam_r[3] - R15,
    " (base reaches ", max(0, f38_base[1] / 2 - cam_r[4]), " in front of the flange)",
    "\n rear clamp ", hw_p ? "M8x" : "M4x", clamp_bolt_len, " tip z = ", clamp_tip_z, " (nut ", nut_top_z, " .. ", nut_top_z - tn_t,
    ", floor ", -tslot_depth, ", max length ", max_bolt(clamp_seat, tslot_depth), ")",
    "\n crosswall: wall_rail face y = ", y_wf, "  mounting face y = ", y_cwm, "  band back y = ", y_cwb, "  rail z ", z_wrl0, " .. ", cw_top,
    " (T-slot at ", wr_z, ")  carriage z ", bc_z0, " .. ", bc_z1, "  frustum margins: rear (15 mm 3:2) ", m_wall_rear, "  bottom ", m_wall_bot,
    "\n wall clamp ", hw_p ? "M8x" : "M4x", wclamp_bolt_len, " tip depth ", wclamp_tip, " (nut ", -nut_top_z, " .. ", -nut_top_z + tn_t,
    ", floor ", tslot_depth, ", max length ", max_bolt(clamp_seat, tslot_depth), ")",
    "\n wall_rail: ", 2 * wrl_half, " x ", cw_top - z_wrl0, " x ", wrl_t, " (printed flat), ", len(wrl_bolt_x), hw_p ? " x M8x" : " x M4x", wrl_bolt_len,
    " through-bolts at x ", wrl_bolt_x, " z ", wr_z + wrl_bolt_h, ": tip ", wrl_tip_u - wrl_nut_u[1], " past the nut (slot from the band top),",
    hw_p ? str(" pins O", pin_d, "x") : " dowels O4x", wrl_dowel_len, " at x ", wrl_dowel_x, " (", wrl_dowel_wall, " in the wall, ", wrl_dowel_len - wrl_dowel_wall, " in the rail)",
    "\n front-brace window clearance of the hex-key lines: carriage clamps ", brace_clear(bc_clamp_x, wr_z),
    "  slide clamps ", brace_clear(slide_bolt_x, bc_bolt_z), "   all 4 bottom clamps reachable from the front at stereo_bot = ",
    key_steps, " (other steps: from the open sides)",
    "\n slides: rear ", 2 * slide_hw, " x ", slide_len(rear_travel), " x ", t_slide, "  bottom ", 2 * slide_hw, " x ",
    slide_len(bot_slot_trav), hw_p ? str("  printed M8 T-bolts (", sb_eng, " in the ", sn_size[1], " mm thumb-nut, pocket roof ",
    min(bc_t, t_rear_carriage) - sb_pd, ") at x = +-", slide_bolt_x) : str("  bolts M4x", slide_bolt_len, " at x = +-", slide_bolt_x,
    " (tip ", slide_tip_d, " below the carriage face, nut ", slide_nut_d, ")"),
    "\n F38 base screw 1/4\"-20 x ", qtr_screw_len, ": ", qtr_under, " of slide under the base, ", qtr_engage,
    " into its thread (depth ", f38_thread_depth, ")", f38_pins ? str("   pins ", f38_pin_d, " in ", f38_pin_hole,
    " press holes, ", f38_pin_depth, " deep") : "   no locating pins",
    "\n preload thread M", ps_d, " x ", ps_pitch, ": depth ", thr_h(ps_pitch), ", radial engagement ", thr_h(ps_pitch) - ps_clear,
    hw_p ? str("\n lid: 4 x M10x", lid_sl, " thumbscrews, engagement front ", lid_eng[0], " (lid + glass_stop ear) / rear ", lid_eng[1],
    " in post-top pads (margin to every frustum / lid view ", m_pads, "), 2 integral pins O", pin_d, " x ", lid_pin_up, " above the posts",
    "   frame height with the pins ", size_frame[2]) : "",
    "\n dowels proud of the carriage: rear ", dowel_len - dowel_depth - t_rear_carriage,
    "  bottom ", dowel_len - dowel_depth - bc_t,
    "\n tripod ", tri_arca ? str("Arca plate ", arca_len, " x ", arca_w, " (2 x M10 at x +-", arca_bx, ") under") : str(tri_38 ? "3/8\"-16" : "1/4\"-20",
    tri_pr ? " printed thread" : " insert"), " at ", tri_xy, " (pad top z ", tri_arca ? arca_boss_top : tri_pad_top, "): stiff plate contact y ",
    tri_xy[1] - tri_solid_d / 2, " .. ", tri_xy[1] + tri_solid_d / 2, " (solid O", tri_solid_d, ", LCD recess ends at y ", lcd_y[1],
    ") + crosswall foot y ", y_wf - web_t, " .. ", y_wf + cw_foot_t + web_t,
    "\n========================================"));
echo("COG_BOUGHT", tri_xy = tri_xy, rear_body = cog_bought[0][1], rear_lens = cog_bought[1][1], rear_f38 = cog_bought[2][1],
     bot_body = cog_bought[3][1], bot_lens = cog_bought[4][1], bot_f38 = cog_bought[5][1], glass = cog_bought[6][1],
     bot_filter = cog_bought[7][1]);

// --- Checks ---
module fits_bed(name, s) {
    assert(s[0] <= bed_limit[0] && s[1] <= bed_limit[1] && s[2] <= bed_limit[2],
           str(name, " exceeds the bed: ", s));
}
fits_bed("frame", size_frame);
fits_bed("top_lid", size_lid);
fits_bed("wall_rail", size_wrl);
fits_bed("hood", size_hood);
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
