ruarchi/BeamSplitter/(list of files, cad)

Other CAD files:
stl/alternatives/frame_tripod_printed.stl
stl/alternatives/frame_tripod_arca.stl
stl/01_frame.stl
stl/11_hardware_screws_solid.stl
stl/13_glass_thumbscrews_solid.stl
